gdimitriu/waiterHomeRobot/moving_engines_processor/MoveEngines.cpp

/*
 * Moving engines processor - Move engines with encoder and sensors
 * Copyright 2022 Gabriel Dimitriu
 *
 * This file is part of waiterHomeRobot project.

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
 * You should have received a copy of the GNU General Public License
 * along with waiterHomeRobot; if not, write to the Free Software
 * Foundation, Inc., 59 Temple Place, Suite 330, Boston, MA  02111-1307
*/

#include <Wire.h>
#include <Adafruit_PWMServoDriver.h>
#include <EnableInterrupt.h>
#include <Servo.h>
#include <NeoSWSerial.h>
#include "configuration.h"
#include "MoveEngines.h"
#include "CollisionSensors.h"

extern Adafruit_PWMServoDriver pwmDriver; 

/**********************************************
 * if has collision if true else false
 * 
 **********************************************/
static volatile bool hasCollision = false;

static volatile uint32_t  left_front_encoder_count = 0;
static volatile uint32_t  right_front_encoder_count = 0;
static volatile uint32_t  left_back_encoder_count = 0;
static volatile uint32_t  right_back_encoder_count = 0;

static float PPI_front_left;
static float PPI_front_right;
static float PPI_back_left;
static float PPI_back_right;
static float currentLeftFrontPosition = 0.0f;
static float currentRightFrontPosition = 0.0f;
static float currentLeftBackPosition = 0.0f;
static float currentRightBackPosition = 0.0f;
bool encoderEnabled = false;

static float distances[4];

int maxPower = ABSOLUTE_MAX_POWER;
int currentPower = maxPower;
int minPower = 2000;

static volatile bool isMovingByHuman = false;

static volatile bool isForwardMove = false;

static volatile uint8_t sensorsReading;

//0 none -1 lower 1 upper
static volatile int switchTriggered = 0;

static Servo rfidServo;

static Adafruit_PWMServoDriver pwmDriver = Adafruit_PWMServoDriver(PCA9685_ADDRESS);

void neoSSerial1ISR() {
    NeoSWSerial::rxISR(*portInputRegister(digitalPinToPort(RxD)));
}

/*
 * isr for encoder pins
 */
static void isrLeftFrontEncoder() {
  left_front_encoder_count++;
}

static void isrRightFrontEncoder() {
  right_front_encoder_count++;
}

static void isrLeftBackEncoder() {
  left_back_encoder_count++;
}

static void isrRightBackEncoder() {
  right_back_encoder_count++;
}

void resetCounters() {
  left_front_encoder_count = 0;
  right_front_encoder_count = 0;
  left_back_encoder_count = 0;
  right_back_encoder_count = 0;
}

void disableEncoders() {
  if ( !encoderEnabled )
    return;
  disableInterrupt(LEFT_FRONT_ENCODER_PIN);
  disableInterrupt(RIGHT_FRONT_ENCODER_PIN);
  disableInterrupt(LEFT_BACK_ENCODER_PIN);
  disableInterrupt(RIGHT_BACK_ENCODER_PIN);  
  encoderEnabled = false;
}

void enableEncoders() {
  if ( encoderEnabled )
    return;
  enableInterrupt(LEFT_FRONT_ENCODER_PIN, isrLeftFrontEncoder, RISING);
  enableInterrupt(RIGHT_FRONT_ENCODER_PIN, isrRightFrontEncoder, RISING);
  enableInterrupt(LEFT_BACK_ENCODER_PIN, isrLeftBackEncoder, RISING);
  enableInterrupt(RIGHT_BACK_ENCODER_PIN, isrRightBackEncoder, RISING);
  encoderEnabled = true;
  resetCounters();
}

// ISR for RFID Servo

static void upperDirStopServo() {
  switchTriggered = 1;
}

static void lowerDirStopServo() {
  switchTriggered = -1;
}

static void stopLeftEngines() {
    pwmDriver.setPWM(LEFT_FRONT_MOTOR_PIN1, 0, 4095);
    pwmDriver.setPWM(LEFT_FRONT_MOTOR_PIN2, 0, 4095);
    pwmDriver.setPWM(LEFT_BACK_MOTOR_PIN1, 0, 4095);
    pwmDriver.setPWM(LEFT_BACK_MOTOR_PIN2, 0, 4095);
}

static void stopRightEngines() {
    pwmDriver.setPWM(RIGHT_FRONT_MOTOR_PIN1, 0, 4095);
    pwmDriver.setPWM(RIGHT_FRONT_MOTOR_PIN2, 0, 4095);
    pwmDriver.setPWM(RIGHT_BACK_MOTOR_PIN1, 0, 4095);
    pwmDriver.setPWM(RIGHT_BACK_MOTOR_PIN2, 0, 4095);
}

void breakAllEngines() {
    if ( isMovingByHuman ) {
      isMovingByHuman = false;
    }
    stopLeftEngines();
    stopRightEngines();
}

static void detectCollisionIsr() {
  hasCollision = true;
}

void checkCollisionIfHuman() {
  if ( isMovingByHuman && hasCollision ) {
    uint8_t  sensors = readSensors();
    if ( isForwardMove ) {
      //forward sensors are triggered
      if ( isFrontLeftCollision(sensors) == true || isFrontCenterCollision(sensors) == true || isFrontRightCollision(sensors) == true ) {
        breakAllEngines();
      }
    } else {
      //rear sensors are triggered
      if ( isRearLeftCollision(sensors) == true || isRearCenterCollision(sensors) == true ||  isRearRightCollision(sensors) == true) {
        breakAllEngines();
      }
    }
  }
}

void engineSetup() {
  //init the PWM driver
  pwmDriver.begin();
  pwmDriver.setOscillatorFrequency(27000000);
  pwmDriver.setPWMFreq(50.0);
  Wire.setClock(400000);
  PPI_front_left = ENCODER_WHEEL_STEPS/(2*PI*WHEEL_RADIUS);
  PPI_front_right = ENCODER_WHEEL_STEPS/(2*PI*WHEEL_RADIUS);
  PPI_back_left = ENCODER_WHEEL_STEPS/(2*PI*WHEEL_RADIUS);
  PPI_back_right = ENCODER_WHEEL_STEPS/(2*PI*WHEEL_RADIUS);
  //enable encoders ISR
  pinMode(LEFT_FRONT_ENCODER_PIN, INPUT_PULLUP);
  pinMode(RIGHT_FRONT_ENCODER_PIN, INPUT_PULLUP);
  pinMode(LEFT_BACK_ENCODER_PIN, INPUT_PULLUP);
  pinMode(RIGHT_BACK_ENCODER_PIN, INPUT_PULLUP);
  encoderEnabled = false;
  //enable interrupt sensors
  pinMode(COLLISION_INTERRUPT_PIN, INPUT_PULLUP);
  enableInterrupt(COLLISION_INTERRUPT_PIN, detectCollisionIsr, FALLING);
  pinMode(RFID_UP_SWITCH_PIN, INPUT_PULLUP);
  enableInterrupt(RFID_UP_SWITCH_PIN, upperDirStopServo, FALLING);
  pinMode(RFID_DOWN_SWITCH_PIN, INPUT_PULLUP);
  enableInterrupt(RFID_DOWN_SWITCH_PIN, lowerDirStopServo, FALLING);
  //enable communication ... all enable interrupt should be in same cpp file
  enableInterrupt(RxD, neoSSerial1ISR, CHANGE);
  lowerRFID();
  raiseRFID();
}

uint32_t getLeftFrontEncoderCount() {
  return left_front_encoder_count;
}

uint32_t getRightFrontEncoderCount() {
  return right_front_encoder_count;
}

uint32_t getLeftBackEncoderCount() {
  return left_back_encoder_count;
}

uint32_t getRightBackEncoderCount() {
  return right_back_encoder_count;
}

/*
* Move the platform in predefined directions.
*/
void go( int speedLeft, int speedRight ) {

  if ( speedLeft == 0 && speedRight == 0 ) {
    pwmDriver.setPWM(LEFT_FRONT_MOTOR_PIN1, 0, 0);
    pwmDriver.setPWM(LEFT_FRONT_MOTOR_PIN2, 0, 0);
    pwmDriver.setPWM(LEFT_BACK_MOTOR_PIN1, 0, 0);
    pwmDriver.setPWM(LEFT_BACK_MOTOR_PIN2, 0, 0);
    pwmDriver.setPWM(RIGHT_FRONT_MOTOR_PIN1, 0, 0);
    pwmDriver.setPWM(RIGHT_FRONT_MOTOR_PIN2, 0, 0);
    pwmDriver.setPWM(RIGHT_BACK_MOTOR_PIN1, 0, 0);
    pwmDriver.setPWM(RIGHT_BACK_MOTOR_PIN2, 0, 0);
    return;
  }
  if ( speedLeft > 0 ) {
    pwmDriver.setPWM(LEFT_FRONT_MOTOR_PIN1, 0, speedLeft);
    pwmDriver.setPWM(LEFT_FRONT_MOTOR_PIN2, 0, 0);
    pwmDriver.setPWM(LEFT_BACK_MOTOR_PIN1, 0, speedLeft);
    pwmDriver.setPWM(LEFT_BACK_MOTOR_PIN2, 0, 0);
  } 
  else {
    pwmDriver.setPWM(LEFT_FRONT_MOTOR_PIN1, 0, 0);
    pwmDriver.setPWM(LEFT_FRONT_MOTOR_PIN2, 0, -speedLeft);    
    pwmDriver.setPWM(LEFT_BACK_MOTOR_PIN1, 0, 0);
    pwmDriver.setPWM(LEFT_BACK_MOTOR_PIN2, 0, -speedLeft);    
  }
 
  if ( speedRight > 0 ) {
    pwmDriver.setPWM(RIGHT_FRONT_MOTOR_PIN1, 0, speedRight);
    pwmDriver.setPWM(RIGHT_FRONT_MOTOR_PIN2, 0, 0);    
    pwmDriver.setPWM(RIGHT_BACK_MOTOR_PIN1, 0, speedRight);
    pwmDriver.setPWM(RIGHT_BACK_MOTOR_PIN2, 0, 0);
  }else {
    pwmDriver.setPWM(RIGHT_FRONT_MOTOR_PIN1, 0, 0);    
    pwmDriver.setPWM(RIGHT_FRONT_MOTOR_PIN2, 0, -speedRight);    
    pwmDriver.setPWM(RIGHT_BACK_MOTOR_PIN1, 0, 0);
    pwmDriver.setPWM(RIGHT_BACK_MOTOR_PIN2, 0, -speedRight);
  }
}

void moveOrRotateUntilStop( int moveData, int rotateData ) {
  //stop command (coasting)
  if ( moveData == 0 && rotateData == 0 ) {
    go(0,0);
    isMovingByHuman = false;
    return;
  }
  isMovingByHuman = true;
  uint8_t  sensors = readSensors();
  sensorsReading = sensors;
  if ( rotateData == 0 ) {    
    if ( moveData < 0 ) {
      if ( isRearLeftCollision(sensors) == false && isRearCenterCollision(sensors) == false && isRearRightCollision(sensors) == false ) {
        isForwardMove = false;
        go(-currentPower,-currentPower);
      }
    } else {      
      if ( isFrontLeftCollision(sensors) == false && isFrontCenterCollision(sensors) == false && isFrontRightCollision(sensors) == false ) {
        isForwardMove = true;
        go(currentPower, currentPower);
      }
    }
  } else {
    if ( rotateData < 0 ) {
      go(-currentPower, currentPower);
    } else {
      go(currentPower, -currentPower);
    }
  }
}

void moveLinear( float distance ) {
  float targetDistance = distance;
  currentLeftFrontPosition = 0.0f;
  currentRightFrontPosition = 0.0f;
  currentLeftBackPosition = 0.0f;
  currentRightBackPosition = 0.0f;

  if ( targetDistance > 0 ) {
    if ( hasCollision ) {
      uint8_t sensors = readSensors();
      if ( isFrontLeftCollision(sensors) == false && isFrontCenterCollision(sensors) == false && isFrontRightCollision(sensors) == false ) {
        go(currentPower,currentPower);
      }
    } else {
      go(currentPower,currentPower);
    }
  } else if ( targetDistance < 0 ) {
    if (hasCollision == true) {
      uint8_t sensors = readSensors();
      if ( isRearLeftCollision(sensors) == false && isRearCenterCollision(sensors) == false && isRearRightCollision(sensors) == false ) {
        go(-currentPower,-currentPower);
        targetDistance = -targetDistance;
      }
    } else {
      go(-currentPower,-currentPower);
      targetDistance = -targetDistance;
    }
  } else {
    return;
  }
  boolean stopLeft = false;
  boolean stopRight = false;
  while( !stopLeft || !stopRight ){
    if ( hasCollision ) {
      breakAllEngines();
      uint8_t sensors = readSensors();
      if ( isFrontLeftCollision( sensors ) || isFrontCenterCollision(sensors) || isFrontRightCollision(sensors) ) {
        //front sensors detect object
        if ( distance < 0 ) { //resume
          hasCollision = false;
          go( -currentPower,-currentPower );
        } else {
          stopLeft = true;
          stopRight = true;
        }
      } else if ( isRearLeftCollision(sensors) || isRearCenterCollision(sensors) || isRearRightCollision(sensors) ) {
        //rear sensors detect object
        if ( distance > 0 ) { //resume
          hasCollision = false;
          go( currentPower,currentPower );          
        } else {
          stopLeft = true;
          stopRight = true;
        }
      } else if ( isRFIDCollision(sensors) ) {
        raiseRFID();
        while ( switchTriggered != 1 ); //wait to raise the RFID
        hasCollision = false;
        if ( distance > 0 )
          go( currentPower,currentPower );
        else if ( distance < 0 ) //should be trigger only forward
          go( -currentPower,-currentPower );
      } else {
        if ( distance > 0 ) {
          go( currentPower,currentPower );
          hasCollision = false;
        } else if ( distance < 0 ) {
          go( -currentPower,-currentPower );
          hasCollision = false;
        }
      }
      
    }
    if ( !stopLeft ) {
      if( ( ( targetDistance - currentLeftBackPosition ) > 0.2) ) {
         currentLeftBackPosition = left_back_encoder_count/PPI_front_left;
      } else {
        stopLeftEngines();
        stopLeft = true;
      }
    }
    if ( !stopRight ) {
      if ( ( ( targetDistance - currentRightBackPosition ) > 0.2 ) ) {
        currentRightBackPosition = right_back_encoder_count/PPI_front_right;
      } else {
        stopRightEngines();
        stopRight=true;
      }
    }
  }
  breakAllEngines();
  delay(100);
  go(0,0);
}

uint32_t ceiling( float value ) {
  uint32_t iVal = value;
  if ( (value - iVal) < 0.5 ) {
    return iVal;
  }
  return iVal++;
}

void rotateDegree( long nr ) {
  if (nr < 0) {
    go(-currentPower,currentPower);
    nr = -nr;
  } else if (nr > 0) {
    go(currentPower,-currentPower);
  } else {
    return;
  }
  boolean stopLeft = false;
  boolean stopRight = false;
  uint32_t current = ceiling((COUNT_ROTATE_90/90.0f) * nr);
  while( !stopLeft || !stopRight ){
    if ( !hasCollision ) {
      if ( !stopLeft ) {
        if ( left_back_encoder_count >= current ) {
           stopLeftEngines();
           stopLeft = true;
        }
      }
      if ( !stopRight )  {
        if ( right_back_encoder_count >= current ) {
          stopRightEngines();
          stopRight = true;
        } 
      }
    } else {
      break;
    }
  }
  breakAllEngines();
  delay(100);  
  go(0,0);
}

bool isInterrupted() {
  return hasCollision;
}

void resetInterrupt() {
  hasCollision = false;
}

float* getCurrentDistances() {  
  distances[0] = currentLeftFrontPosition;
  distances[1] = currentRightFrontPosition;
  distances[2] = currentLeftBackPosition;
  distances[3] = currentRightBackPosition;
  return distances;
}


void raiseRFID() {
  if ( digitalRead(RFID_DOWN_SWITCH_PIN) == LOW ) {
     switchTriggered = 0;
     rfidServo.attach(RFID_SERVO_PIN);
     rfidServo.write(180);
  } else {
    if ( digitalRead(RFID_DOWN_SWITCH_PIN) == HIGH && digitalRead(RFID_UP_SWITCH_PIN) == HIGH ) { // in the middle
      switchTriggered = 0;
      rfidServo.attach(RFID_SERVO_PIN);
      rfidServo.write(180);
    }
  }
  while ( switchTriggered != 1 );
  rfidServo.detach();
}

void lowerRFID() {
  if ( digitalRead(RFID_UP_SWITCH_PIN) == LOW ) {
     switchTriggered = 0;
     rfidServo.attach(RFID_SERVO_PIN);
     rfidServo.write(0);
  } else {
    if ( digitalRead(RFID_DOWN_SWITCH_PIN) == HIGH && digitalRead(RFID_UP_SWITCH_PIN) == HIGH ) { // in the middle
      switchTriggered = 0;
      rfidServo.attach(RFID_SERVO_PIN);
      rfidServo.write(0);
    }
  }
  while ( switchTriggered != -1 );
  rfidServo.detach();
}

int rfidPosition() {
  if ( digitalRead(RFID_DOWN_SWITCH_PIN) == HIGH && digitalRead(RFID_UP_SWITCH_PIN) == HIGH ) { //middle
    return 2;
  }
  if ( digitalRead(RFID_DOWN_SWITCH_PIN) == LOW && digitalRead(RFID_UP_SWITCH_PIN) == LOW ) { //impossible
    return -2;
  }
  if ( digitalRead(RFID_UP_SWITCH_PIN) == LOW ) {
    return 1;
  }
  if ( digitalRead(RFID_DOWN_SWITCH_PIN) == LOW ) {
    return -1;
  }
}
