gdimitriu/waiterHomeRobot/stage2_mega/configuration.h

/*
 * Stage 2 - configuration
 * 
 * Copyright 2023 Gabriel Dimitriu
 *
 * This file is part of waiterHomeRobot project.

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
 * You should have received a copy of the GNU General Public License
 * along with waiterHomeRobot; if not, write to the Free Software
 * Foundation, Inc., 59 Temple Place, Suite 330, Boston, MA  02111-1307
*/

#ifndef __CONFIGURATION_H__
#define __CONFIGURATION_H__
/**********************************************************************
 *
 * Flags to activate standalone tests for components
 *
 **********************************************************************/

//#define IS_STANDALONE 

 /**********************************************
 * 
 * uncomment this to have serial debug
 * 
 **********************************************/
#ifdef IS_STANDALONE 
  #define SERIAL_DEBUG
#else  
 //#define SERIAL_DEBUG
#endif
/**********************************************
 * 
 * uncomment this to have LCD test
 * 
 **********************************************/
//#define TEST_LCD

/*********************************************
 * 
 * uncomment this to have read from SD and
 * print on LCD test
 * data are into tests/sd_lcd.txt
 * 
 *********************************************/
//#define TEST_SD_LCD

/*********************************************************************
 * 
 * Real Functionality
 * 
 *********************************************************************/

/*********************************************
 * 
 * this is used when lcd is color inverse
 * 255 means color off
 * 
 *********************************************/
//#define LCD_IS_COlOR_INVERSE

/**********************************************
 * 
 * serial port for brain or communication device
 *  
 **********************************************/
#ifndef IS_STANDALONE
  #define BRAIN_COMM_SERIAL Serial3
#else  
  #define BRAIN_COMM_SERIAL Serial
#endif

/**********************************************
 * 
 * serial port for engine processor
 *  
 **********************************************/
#define ENGINES_PROC_SERIAL Serial2
/**********************************************
 * DC from ILI9341 pin
 * 
 **********************************************/
#define DC_LCD 23

/**********************************************
 * RESET from ILI9341 pin
 * 
 **********************************************/
#define RST_LCD 22

/**********************************************
 * CS from ILI9341 pin
 * unused on my board because it does not have it
 * choose something that is not used
 **********************************************/
#define CS_LCD 26

/**********************************************
 * 
 * if has SD CARD READER
 *  
 **********************************************/
#define HAS_SD

/**********************************************
 * 
 * CS from SD board pin
 * 
 **********************************************/
#define CHIP_SELECT_SD 25

/**********************************************
 * 
 * CD from SD board pin
 * 
 **********************************************/
#define CARD_DETECT_SD 24

/**********************************************
 * 
 * Speaker PIN
 * 
 **********************************************/
#define LEFT_SPEAKER_PIN 10

/**********************************************
 * 
 * if has rfid MFRC522
 *  
 **********************************************/
//#define HAS_RFID

/**********************************************
 * 
 * ss pin for rfid
 *  
 **********************************************/
#define SS_RFID_PIN 27

/**********************************************
 * 
 * power monitoring pin
 *  
 **********************************************/
#define POWER_MONITORING_PIN A0

/**********************************************
 * 
 * power monitoring interval in ms
 *  
 **********************************************/
#define POWER_MONITORING_INTERVAL 60000

/**********************************************
 * 
 * ultrasonics servo pin
 *  
 **********************************************/
#define ULTRASONIC_SERVO_PIN 2

/**********************************************
 * 
 * ultrasonics front trigger pin
 *  
 **********************************************/
#define ULTRASONIC_FRONT_TRIG_PIN 3

/**********************************************
 * 
 * ultrasonics front echo pin
 *  
 **********************************************/
#define ULTRASONIC_FRONT_ECHO_PIN 4


/**********************************************
 * 
 * ultrasonics rear trigger pin
 *  
 **********************************************/
#define ULTRASONIC_REAR_TRIG_PIN 5

/**********************************************
 * 
 * ultrasonics rear echo pin
 *  
 **********************************************/
#define ULTRASONIC_REAR_ECHO_PIN 6

/**********************************************
 * 
 * rear distance from sensor to chassy in cm
 *  
 **********************************************/
#define REAR_DISTANCE 38
#endif
