gdimitriu/waiterHomeRobot/moving_engines_processor/CollisionSensors.cpp

/*
 * Moving engines processor - Colission sensors module
 * Copyright 2023 Gabriel Dimitriu
 *
 * This file is part of waiterHomeRobot project.

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
 * You should have received a copy of the GNU General Public License
 * along with waiterHomeRobot; if not, write to the Free Software
 * Foundation, Inc., 59 Temple Place, Suite 330, Boston, MA  02111-1307
*/

#include <Wire.h>
#include <PCF8574.h>
#include "CollisionSensors.h"
#include "configuration.h"
#define REAR_RIGHT_MASK 0b00000001 //0
#define REAR_CENTER_MASK 0b00000010 //1
#define REAR_LEFT_MASK 0b00000100 //2
#define FRONT_RIGHT_MASK 0b00001000 //3
#define FRONT_CENTER_MASK 0b00010000 //4
#define FRONT_LEFT_MASK 0b00100000 //5
#define RFID_COLLISION_MASK 0b01000000 //6
#define PIN7_MASK 0b10000000

static PCF8574 expander;

void initCollisionSensors() {
  expander.begin(PCF8574_ADDRESS);
  expander.pinMode(0, INPUT_PULLUP); //right rear sensor
  expander.pinMode(1, INPUT_PULLUP); //center rear sensor
  expander.pinMode(2, INPUT_PULLUP); //left rear sensor
  expander.pinMode(3, INPUT_PULLUP); //right front sensor
  expander.pinMode(4, INPUT_PULLUP); //center front sensor
  expander.pinMode(5, INPUT_PULLUP); //left front sensor
  expander.pinMode(6, INPUT_PULLUP); //RFID Collision sensor
}

uint8_t readSensors() {  
  return expander.read();
}

bool isFrontLeftCollision(uint8_t sensors) {
  if (( sensors & FRONT_LEFT_MASK ) > 0) {
    return false;
  }
  return true;
}

bool isFrontCenterCollision(uint8_t sensors) {
  if (( sensors & FRONT_CENTER_MASK ) > 0) {
    return false;
  }
  return true;
}

bool isFrontRightCollision(uint8_t sensors) {
  if (( sensors & FRONT_RIGHT_MASK ) > 0) {
    return false;
  }
  return true;
}

bool isRearCenterCollision(uint8_t sensors) {
  if (( sensors & REAR_CENTER_MASK ) > 0) {
    return false;
  }
  return true;
}

bool isRearLeftCollision(uint8_t sensors) {
  if (( sensors & REAR_LEFT_MASK ) > 0) {
    return false;
  }
  return true;
}

bool isRearRightCollision(uint8_t sensors) {
  if (( sensors & REAR_RIGHT_MASK ) > 0) {
    return false;
  }
  return true;
}

bool isRFIDCollision(uint8_t sensors) {
  if (( sensors & RFID_COLLISION_MASK ) > 0) {
    return false;
  }
  return true;
}
