gdimitriu/waiterHomeRobot/stage2_mega/sd_operations.cpp

/*
 * Stage 2 - SD card operations
 * 
 * This is used only for LCD and other operations not for Sound Module.
 * 
 * Copyright 2023 Gabriel Dimitriu
 *
 * This file is part of waiterHomeRobot project.

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
 * You should have received a copy of the GNU General Public License
 * along with waiterHomeRobot; if not, write to the Free Software
 * Foundation, Inc., 59 Temple Place, Suite 330, Boston, MA  02111-1307
*/

#include "sd_operations.h"
#include "lcd_operations.h"
#include <TMRpcm.h>

#define LINE_SIZE 256


static TMRpcm tmrpcm;

static bool alreadyBegan = false;  // SD.begin() misbehaves if not first call
static char lineBuffer[LINE_SIZE];
static File fd;


void initSDCardReader() {
#ifdef SERIAL_DEBUG  
  Serial.println("InitSD");
#endif
#ifndef IS_STANDALONE
  pinMode(CARD_DETECT_SD, INPUT);
  // Is there even a card?
  if (!digitalRead(CARD_DETECT_SD)) {
    resetLinePos();
    while (!digitalRead(CARD_DETECT_SD)) {
      Serial.println("enter card");
      printNextLineText("Enter card",24);
      delay(1000);
    }
    resetLinePos();
    delay(250); // 'Debounce insertion'
  }
#endif  
  // Card seems to exist.  begin() returns failure
  // even if it worked if it's not the first call.
  if (!SD.begin(CHIP_SELECT_SD) && !alreadyBegan)  // begin uses half-speed...
  {
#ifdef SERIAL_DEBUG
    if(SD.begin(CHIP_SELECT_SD)) {
      Serial.println("fail");
    }
#endif    
    initSDCardReader(); // Possible infinite retry loop is as valid as anything
  }
  else
  {
    alreadyBegan = true;
  }
  tmrpcm.speakerPin = LEFT_SPEAKER_PIN;
}

bool openFile(char *fileName) {
  if (fd) {
    fd.close();
  }
  fd = SD.open(fileName);
  if (!fd || !SD.exists(fileName)) {
    return false;
  }
  return true;
}

void removeFile(char *fileName) {
  if ( SD.exists(fileName) ) {
    SD.remove(fileName);
    return true;
  }
}

bool openWriteFile(char *fileName) {
  if (fd) {
    fd.close();
  }
  if ( SD.exists(fileName) ) {
    SD.remove(fileName);
  }
  fd = SD.open(fileName, FILE_WRITE);
  if ( !fd )
    return false;
  return true;
}

void closeFile() {
  if(fd) {
    fd.close();
  }
}

char* readNextLine() {
  memset(lineBuffer, 0, sizeof(char)*LINE_SIZE);
  int index = 0;
  while (fd.available()) {
    char ch = fd.read();      
    if (ch == '\n') {
      return lineBuffer;
    } else {
      if (index > LINE_SIZE) {
        return lineBuffer;
      }
      lineBuffer[index++] = ch;
      lineBuffer[index] = '\0';
    }
  }
  return NULL;
}

void readFullFile(char *buffer, unsigned int size) {
  memset(buffer, 0, sizeof(char)*size);
  int index = 0;
  while (fd.available()) {
    char ch = fd.read();      
    if (index > size) {
      return;
    }
    buffer[index++] = ch;
    buffer[index] = '\0';
  }
}

void writeNextLine(char *value) {
  fd.write(value, strlen(value) * sizeof(char));
  fd.write('\n');
}

#ifdef TEST_SD_LCD  
  void printInSetupSdLcdTest() {    
    char fileName[] = "tests/sd_lcd.txt";
#ifdef SERIAL_DEBUG    
    Serial.println("before");
#endif    
    printCurrentFilePath(fileName);
#ifdef SERIAL_DEBUG    
    Serial.println("after");
#endif    
    if(openFile("tests/sd_lcd.txt")) {
      char * line = readNextLine();
#ifdef SERIAL_DEBUG      
      Serial.println(line);
#endif      
      while(line != NULL) {
        printNextLineText(line,24);
#ifdef SERIAL_DEBUG        
        Serial.println(line);
#endif        
        line = readNextLine();
      }
      closeFile();
    }
#ifdef SERIAL_DEBUG    
    else {
      Serial.println("File does not exist");
    }
#endif    
  }
#endif

void playSound(char *fileName) {
  tmrpcm.setVolume(6);
  tmrpcm.play(fileName);
}
