gdimitriu/waiterHomeRobot/stage2_mega/lcd_operations.cpp

/*
 * Stage 2 - LCD operations
 * 
 * Copyright 2023 Gabriel Dimitriu
 *
 * This file is part of waiterHomeRobot project.

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
 * You should have received a copy of the GNU General Public License
 * along with waiterHomeRobot; if not, write to the Free Software
 * Foundation, Inc., 59 Temple Place, Suite 330, Boston, MA  02111-1307
*/

#include <SPI.h>
#include <Ucglib.h>
#include "lcd_operations.h"

#define CUSTOM_MESSAGES 36
#ifdef LCD_IS_COlOR_INVERSE
  #define MAX_COLOR 0
  #define MIN_COLOR 255
#else
  #define MAX_COLOR 255
  #define MIN_COLOR 0
#endif

static Ucglib_ILI9341_18x240x320_HWSPI ucg(/*cd=*/ DC_LCD , /*cs=*/ CS_LCD, /*reset=*/ RST_LCD);

static ucg_int_t currentPosition;

void showStartMessage() {
  ucg.setFont(ucg_font_helvB24_hr);
  ucg.setPrintDir(0);
  ucg.setColor(MIN_COLOR,MIN_COLOR ,MIN_COLOR);
  ucg.setPrintPos(24, ucg.getHeight() - CUSTOM_MESSAGES - 10);
  ucg.print("Have a Nice Day !");  
  ucg.setColor(MAX_COLOR,MAX_COLOR ,MIN_COLOR);
  ucg.drawDisc(ucg.getWidth()/2, CUSTOM_MESSAGES+75, 44, UCG_DRAW_ALL);
  ucg.setColor(MIN_COLOR,MAX_COLOR,MAX_COLOR);
  ucg.drawDisc(ucg.getWidth()/2, CUSTOM_MESSAGES+85, 5, UCG_DRAW_ALL);
  ucg.setColor(MAX_COLOR,MIN_COLOR ,MIN_COLOR);
  ucg.drawBox(ucg.getWidth()/2-20, CUSTOM_MESSAGES+95, 40, 10);
  ucg.drawDisc(ucg.getWidth()/2-20, CUSTOM_MESSAGES + 63, 10, UCG_DRAW_ALL);
  ucg.drawDisc(ucg.getWidth()/2+20, CUSTOM_MESSAGES + 63, 10, UCG_DRAW_ALL);
}

void initLCD() {
  ucg.begin(UCG_FONT_MODE_TRANSPARENT);
  ucg.clearScreen();
  ucg.setRotate270();
  currentPosition = CUSTOM_MESSAGES;
  ucg.setFont(ucg_font_helvB12_hr);
  ucg.setColor(MIN_COLOR, MAX_COLOR, MIN_COLOR);
  ucg.drawBox(0, 0, ucg.getWidth(), CUSTOM_MESSAGES);
  ucg.setColor(MAX_COLOR, MIN_COLOR, MIN_COLOR);
  ucg.setPrintDir(0);
  ucg.setPrintPos(2, 17);
  ucg.print("Current file path");
  showStartMessage();
}

void resetLinePos() {
  ucg.setColor(MAX_COLOR, MAX_COLOR, MAX_COLOR);
  ucg.drawBox(0, CUSTOM_MESSAGES, ucg.getWidth(), ucg.getHeight() - 2 * CUSTOM_MESSAGES );
  currentPosition = CUSTOM_MESSAGES;
}

bool printNextLineText(char *text, uint8_t fontSize) {
  switch(fontSize) {
    case 8:
      ucg.setFont(ucg_font_helvB08_hr);
      currentPosition  += 13;
      if ( currentPosition > ( ucg.getHeight() - CUSTOM_MESSAGES ) ) {
        return false;
      }
      break;
    case 24:
      ucg.setFont(ucg_font_helvB24_hr);
      currentPosition += 29;
      if ( currentPosition > ( ucg.getHeight() - CUSTOM_MESSAGES ) ) {
        return false;
      }
      break;
  }
  ucg.setColor(MIN_COLOR, MIN_COLOR, MIN_COLOR);
  ucg.setPrintPos(2, currentPosition);
  ucg.setPrintDir(0);
  ucg.print(text);
  return true;
}

void printCurrentFilePath(char *filePath) {
  ucg.setFont(ucg_font_helvB12_hr);
  ucg.setColor(MIN_COLOR, MAX_COLOR, MIN_COLOR);
  ucg.drawBox(0, 0, ucg.getWidth(), CUSTOM_MESSAGES);
  ucg.setColor(MAX_COLOR, MIN_COLOR, MIN_COLOR);
  ucg.setPrintDir(0);
  ucg.setPrintPos(2,17);
  ucg.print("Current file path");
  ucg.setPrintPos(2,CUSTOM_MESSAGES - 2);
  ucg.setPrintDir(0);
  ucg.print(filePath);
}


void printCurrentACCPower(float value) {
  ucg.setFont(ucg_font_helvB24_hr);
  ucg.setColor(MIN_COLOR, MAX_COLOR, MIN_COLOR);
  ucg.drawBox(0, ucg.getHeight() - CUSTOM_MESSAGES, ucg.getWidth(), ucg.getHeight());
  ucg.setColor(MAX_COLOR, MIN_COLOR, MIN_COLOR);
  ucg.setPrintDir(0);
  ucg.setPrintPos(2,ucg.getHeight() - 7);
  char buffer[50];
  char szF[7];
  memset(szF,0,sizeof(char)*7);
  dtostrf( value, 4, 2, szF );
  memset(buffer,0,sizeof(char)*50);
  sprintf(buffer,"Power : %s V",szF);
  ucg.print(buffer);
}

/**********************************************************************
 *
 * standalone tests enabled by TEST_LCD flag
 *
 **********************************************************************/
#ifdef TEST_LCD

  void printInSetupLcdTest() {
    printCurrentFilePath("route 1");
    printNextLineText("line 1",24);
    printNextLineText("line 2",24);
    printNextLineText("line 3",24);
    printNextLineText("line 4",24);  
  }

  void printInLoopLcdTest() {
    delay(5000);
    char buffer[50];
    memset(buffer,0,sizeof(char)*50);
    resetLinePos();
    for(int i = 0; i < 7; i++) {
      memset(buffer,0,sizeof(char)*50);
      sprintf(buffer,"line %d",i);
      printNextLineText(buffer,24);
    }
    for(int i = 0; i < 10; i++) {
      memset(buffer,0,sizeof(char)*50);
      sprintf(buffer,"route %d",i);
      printCurrentFilePath(buffer);
      delay(1000);    
    }
  }
#endif
