gdimitriu/waiterHomeRobot/stage2_mega_w_arms/rfid.cpp

/*
 * Moving engines processor - RFID reader
 * Copyright 2022 Gabriel Dimitriu
 *
 * This file is part of waiterHomeRobot project.

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
 * You should have received a copy of the GNU General Public License
 * along with waiterHomeRobot; if not, write to the Free Software
 * Foundation, Inc., 59 Temple Place, Suite 330, Boston, MA  02111-1307
*/
/* mifare ultralight example (25-02-2018)
 *
 *   RFID-RC522 (SPI connexion)
 *   
 *   CARD RC522      Arduino (UNO)
 *     SDA  -----------  10 (Configurable, see SS_PIN constant)
 *     SCK  -----------  13
 *     MOSI -----------  11
 *     MISO -----------  12
 *     IRQ  ----------- 
 *     GND  -----------  GND
 *     RST  -----------  9 (onfigurable, see RST_PIN constant)
 *     3.3V ----------- 3.3V
 *     
 */

#include "rfid.h"
#include "configuration.h"
#include <SPI.h>
#include <MFRC522.h>

MFRC522 *mfrc522;
//Ultraligth mem = 36 pages. 4 bytes per page. 
//Pages 0 to 4 are for special functions.
//it has 36 pages https://www.optimusdigital.ro/ro/wireless-rfid/2548-sticker-nfc-ntag203-alb-rotund-144-bytes.html

static byte readBuffer[18]; //16 + 2 CRC
static byte size = sizeof(byte) * BUFFER_SIZE;
static uint8_t pageAddr = 0x06;

void initRFID() {
  mfrc522 = new MFRC522(SS_RFID_PIN,MFRC522::UNUSED_PIN);
  mfrc522->PCD_Init(); // Init MFRC522 card
}
bool isCardPresent() {
  if ( ! mfrc522->PICC_IsNewCardPresent())
    return false;

  // Select one of the cards
  if ( ! mfrc522->PICC_ReadCardSerial())
    return false;
  return true;
}

bool readRFID(char *inData, uint8_t &bufferPos) {
  
  MFRC522::StatusCode status;
  memset(inData, 0, BUFFER_SIZE);
  bufferPos = 0;
  for (int j = 0; j < floor(ULTRALIGHT_C_PAGES/4.0); ++j) {
    memset(readBuffer, 0, 18);
    //data in 4 blocks is readed at once.
    status = (MFRC522::StatusCode) mfrc522->MIFARE_Read(pageAddr+(j*4), readBuffer, &size);
    if (status != MFRC522::STATUS_OK) {
      return false;
    }
    memcpy(&inData[bufferPos],readBuffer,16);
    bufferPos += 16;
  }
  return true;
}
