gdimitriu/waiterHomeRobot/(commit log)

2022-12-23 first version with only encoders
    [configuration.h]
2022-12-31 start to add colission sensors
    [configuration.h]
2023-01-11 added proximity sensors
2023-01-19 modified to reflect current hardware and vision
    [configuration.h]
2023-01-22 start the work on stage2
    [configuration.h]
2023-01-26 added calibaration for sensors still a bug for fast sensors
    [pcf8574_int_sensors.ino]
2023-01-27 added some utils for arduino
2023-01-28 added docs
    [configuration.h]
2023-01-29 added docs + refactor some code
    [configuration.h]
2023-02-01 commit before refactorization
    [configuration.h]
2023-02-06 first working version with ble
    [configuration.h]
2023-02-25 final version with current engines no power for hobby engines
    [configuration.h]
2023-03-22 added rfid servo + sensor
2023-04-05 version after upgrade the hw
    [configuration.h]
2023-07-15 changed direction
    [configuration.h]
2023-07-23 solved some bugs
    [configuration.h]
2023-12-29 added untested version for esp32 with camera
2024-02-18 moved ble to mega
    [configuration.h]
2024-03-07 first working version with power monitoring
    [configuration.h]
2024-05-04 added some new lcd commands
    [configuration.h]
2024-05-13 added new lcd commands
    [configuration.h]
2024-05-20 solved some bugs for lcd display
    [configuration.h]
2024-08-08 start to add ultrasonics
    [configuration.h]
